ruka-hand-v2/RUKA-V2-Assembly-Instruction/docs/cad-files.md

---
icon: file-cad
---

# CAD Files

### Complete CAD File

[RUKA-V2](https://cad.onshape.com/documents/59040ba514e65eea2b4930b4/w/888a0bf0536dace5ae45ae11/e/b99b5b115b7d9a00526e0b03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\&uiState=6a787c7d9190f53244ae9687)

### Download and print parts

Plate STLs

<table><thead><tr><th width="259.3046875">Print Setting</th><th>Right Hand</th><th>Left Hand</th></tr></thead><tbody><tr><td>100% infill, 0.2mm layer height</td><td></td><td></td></tr><tr><td>50% infill, 0.2mm layer height</td><td></td><td></td></tr><tr><td>50% infill, 0.2mm layer height</td><td></td><td></td></tr><tr><td>100% infill, 0.2mm layer height</td><td></td><td></td></tr><tr><td>100% infill, 0.2mm layer height</td><td></td><td></td></tr><tr><td>30% infill, 0.2mm layer height</td><td></td><td></td></tr><tr><td>100% infill, 0.2mm layer height</td><td></td><td></td></tr><tr><td>100% infill, 0.2mm layer height</td><td></td><td></td></tr></tbody></table>

{% file src=".gitbook/assets/Kunckle_Left.stl" %}

### Finger Tip Replacements

| Print Setting | Files |
| --- | --- |
| |  |
| |  |
| | <div data-gb-custom-block data-tag="file" data-src=".gitbook/assets/AllFingertipTPU.3mf"><p>&#x3C;/</p></div> |

### Encoder Mounts

| Print Setting | Files |
| --- | --- |
| |  |
