ruka-hand-v2/RUKA-V2-Assembly-Instruction/docs/.gitbook/assets/Kunckle_Right.stl

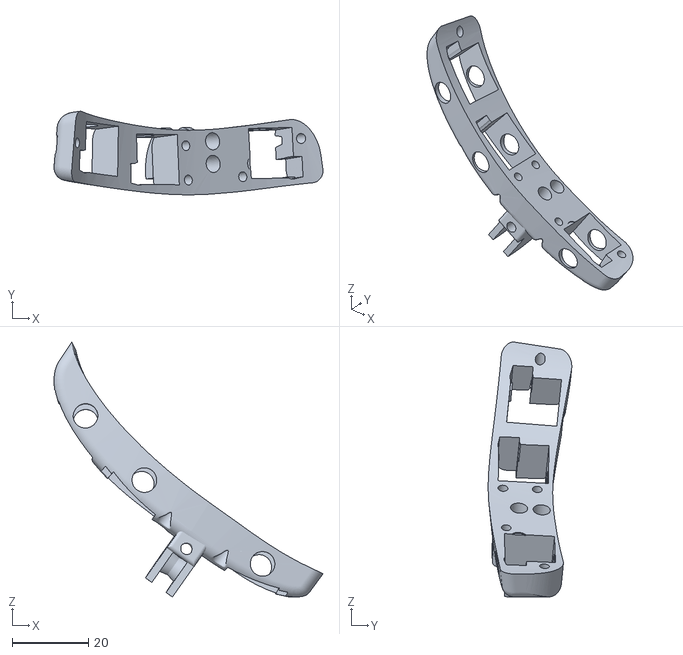
[picture p1: CAD file, 2026-08-09]
docs/.gitbook/assets/Kunckle_Right.stl
70.4 x 21.9 x 66.7
