ruka-hand-v2/RUKA-V2-Assembly-Instruction/docs/.gitbook/assets/Kunckle_Left.stl

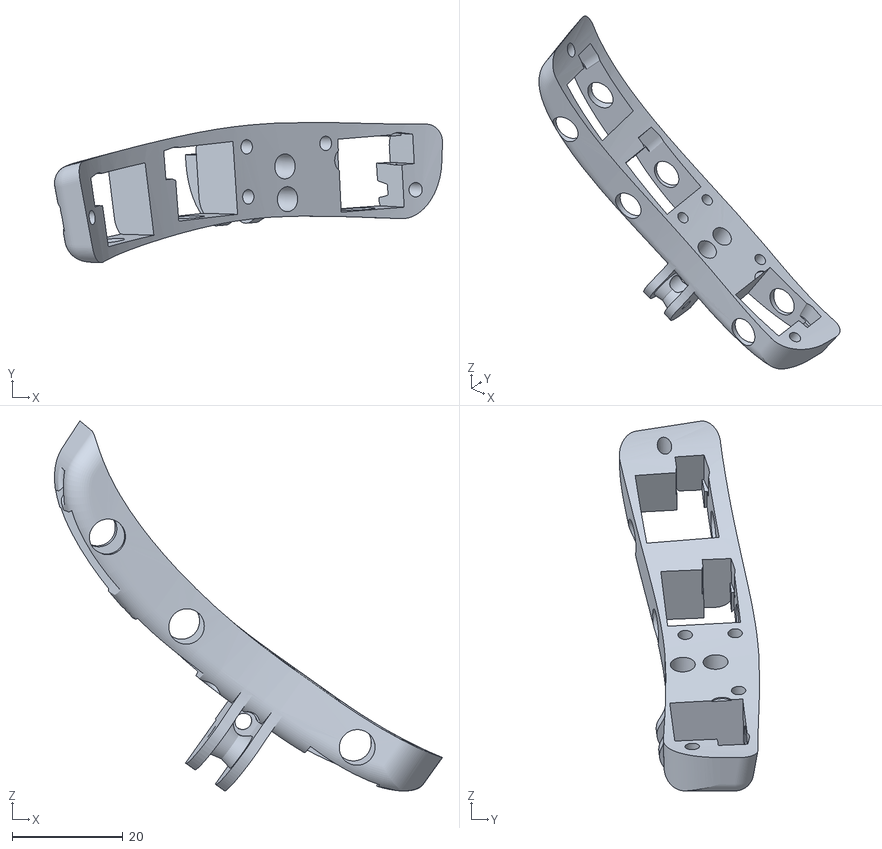
[picture p2: CAD file, 2026-08-09]
docs/.gitbook/assets/Kunckle_Left.stl
70.0 x 25.3 x 66.7
