ruka-hand-v2/RUKA-V2-Assembly-Instruction/docs/.gitbook/assets/SensorSuiteSmallMagnetRightHand.3mf

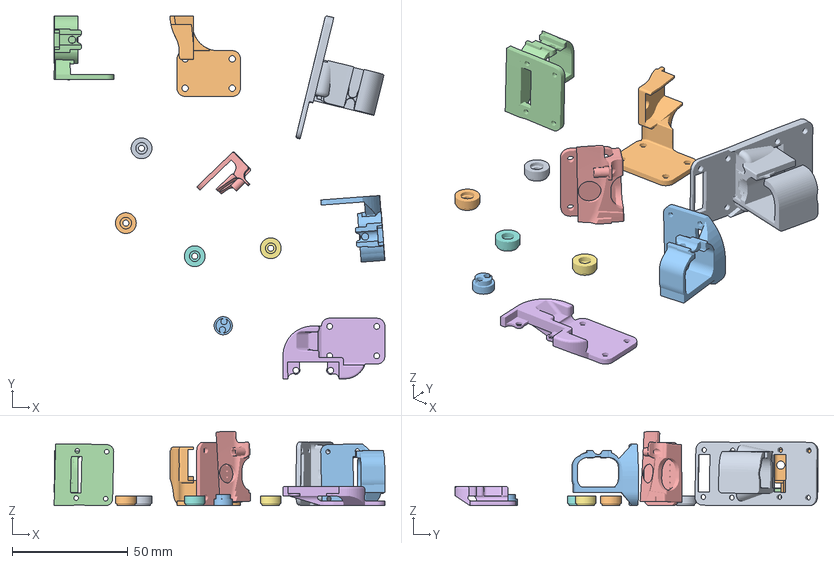
[picture p3: CAD file, 2026-04-23]
docs/.gitbook/assets/SensorSuiteSmallMagnetRightHand.3mf
142.8 x 156.7 x 32.1 mm
MCPEncoderHolder.stl
ThumbMCPAS5600.stl
ThumbDIPAS5600.stl
DIPAS5600.stl
AbductionHolderV2.stl
ThumbBottomHolder.stl
DiscHolderSmall.stl x 2
DiscHolderMediumMagnet1mm.stl x 2
AbductionCap.stl
