ruka-hand-v2/RUKA-V2-Assembly-Instruction/docs/assembly/step-05-final.md

# Step 05 — Wrist Assembly

### 1. Before Assembly

* Make sure that the ball joint is polished, and test it with the wrist connector; it should move freely.

### 2. Assembly Instruction

{% embed url="https://youtu.be/Rm0DyU4A358" %}

#### Bearings Insertion

| Required Parts | Quantity |
| --- | --- |
| Base | 1 |
| Inner Linkage | 1 |
| Outer Linkage | 1 |
| Bearings (10mm OD, 5mm Inner) | 8 |

<mark style="color:$danger;">Suggestion: Use a bench clamp if it is difficult to press in.</mark>

<figure><figcaption></figcaption></figure>

<figure><figcaption></figcaption></figure>

#### Wrist Assembly

| Required Parts | Quantity |
| --- | --- |
| Wrist Components | |
| M2 \* 12 Screw | 4 |
| M5 \* 20 Screw | 6 |
| M5 Washer | >8 |
| M5 Lock Nuts | 5 |

1. Press the wrist connector into the inner linkage.

<figure><figcaption></figcaption></figure>

2. Use four M2 \* 12 screw to fix it. <mark style="color:$danger;">CAUTION: Do not over-tighten the screws; make sure that the grey part moves freely.</mark>

<figure><figcaption></figcaption></figure>

3. Assemble the wrist as shown below. Please refer to the assembly video for more specific steps.

<mark style="color:$danger;">Please use washers between moving parts.</mark>

<mark style="color:$danger;">Adjust the washer numbers between parts to ensure that the rotation center is at the center of the ball joint.</mark>

<figure><figcaption></figcaption></figure>

<figure><figcaption></figcaption></figure>

#### Wrist Routing

{% embed url="https://youtu.be/GrFL19Z3Onc" %}

{% embed url="https://youtu.be/DixnyVoC6T4" %}

Things to Prepare:

* Tape
* Tweezers

<mark style="color:$danger;">Things to Pay Attention:</mark>

* <mark style="color:$danger;">Make sure that the strings are not entangling with each other.</mark>
* <mark style="color:$danger;">Verify finger movement after routing.</mark>

Steps:

1. Group and tape the strings at the wrist connector.

<figure><figcaption></figcaption></figure>

2. Route the strings through the wrist group by group, and check for overlapping during the process.

<figure><figcaption></figcaption></figure>

#### Bearing Plate

The printer setting may affect the dowel hole size. If you find it is extremely difficult to insert the dowel, please try re-printing the plate with a larger layer height, or use a 2.5mm drill to enlarge the hole.

<figure><figcaption></figcaption></figure>

{% embed url="https://youtu.be/YHv7OPIKRvE" %}

| Ring Finger Plate | Thumb + Middle + Index | Pinky |
| --- | --- | --- |
|  |  |  |
