ruka-hand-v2/RUKA-V2-Assembly-Instruction/(commit log)

2026-04-23 Added encoder cad files
    [SensorSuiteSmallMagnetRightHand.3mf]
2026-04-23 Added reference to right encoder files
2026-04-25 Added encoders documentation
2026-04-25 Added encoders to the summary
2026-04-25 Fixed some formatting on th encoders
2026-08-09 GITBOOK-4: No subject
    [Kunckle_Left (1).stl, Kunckle_Left.stl, Kunckle_Right.stl]
